chiu9287/Arduino_ROBOT/歷年機器人/2024_2輪驅動(避障、PID)/圖片/框架(反).jpg

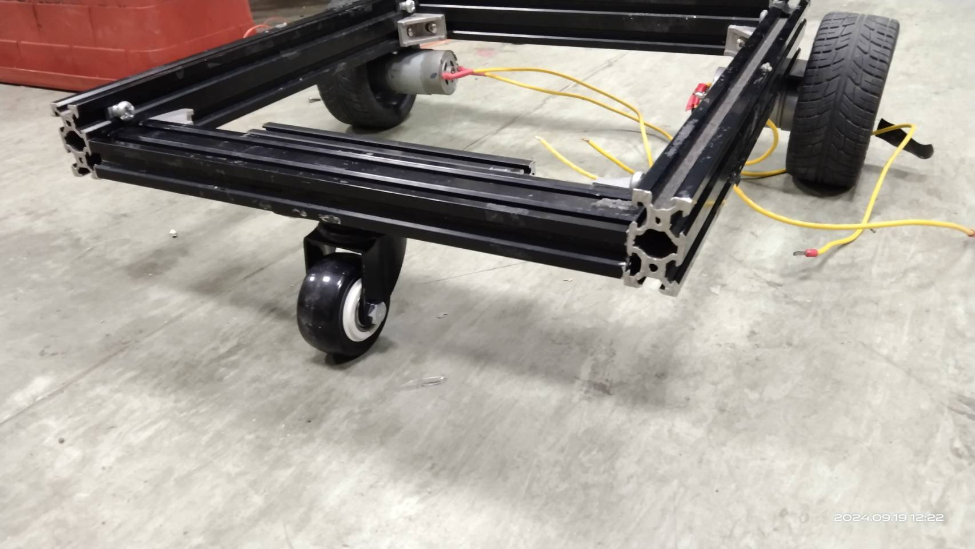
歷年機器人/2024_2輪驅動(避障、PID)/圖片/框架(反).jpg
