chiu9287/Arduino_ROBOT/README.md

# Arduino_ROBOT
黃威仁實驗室_田間機器人

此處存放機器人相關零件資料、製作紀錄以及程式碼，供日後學弟妹製作使用。

## 檔案架構

```
Arduino_ROBOT
├─基本功能
│  ├─程式碼
│  │  └─main
│  └─零件相關資料
│      ├─FSR_402(壓力感測)
│      │  └─程式
│      ├─HX711(電子秤)
│      │  └─程式
│      ├─L298N(燈條控制器)
│      │  └─程式
│      ├─L298N(馬達控制)
│      │  └─程式
│      ├─laser(雷射)
│      │  └─程式
│      ├─LCD_I2C(LCD顯示器)
│      │  └─程式
│      ├─MG_996R(伺服馬達)
│      │  └─程式
│      ├─MPU_6050(陀螺儀)
│      │  └─程式
│      ├─RGB_LED(LED燈泡)
│      │  └─程式
│      ├─SR04(超音波測距)
│      │  └─程式
│      ├─VL35L0X(雷射測距)
│      │  └─程式
│      └─WT61C(陀螺儀)
│          └─程式
└─歷年機器人
    ├─2023_4輪驅動(避障、PID、影像辨識控制)
    │  ├─圖片
    │  ├─影片
    │  └─程式碼
    │      └─main
    ├─2024_2輪驅動(避障、PID)
    │  ├─圖片
    │  ├─影片
    │  └─程式碼
    │      └─main
    ├─2024_木木梟沒有在跟你開玩笑(RGB、雷射、測重、壓力、LCD、陀螺儀)
    │  └─程式碼
    │      ├─Arduino
    │      │  ├─...
    │      └─libraries
    │          ├─...
    ├─2024競賽
    ├─2025_阿不對不隊
    │  ├─室外關
    │  └─程式碼
    │  ├─室內關
    │  └─程式碼
    └─2025競賽

```
