chiu9287/Arduino_ROBOT/歷年機器人/2024競賽/賽道介紹圖.md

## 賽道圖
賽道圖

## 賽道A
賽道A

## 賽道B+C
賽道B

賽道C

## 賽道D
賽道D

## 賽道E
賽道E
