chiu9287/Arduino_ROBOT/歷年機器人/2025競賽/賽道介紹圖.md

# 室外賽道圖
賽道示意圖(室外)

## 賽道A
A

## 賽道B
B

## 賽道C
C

## 賽道D
D

# 室內賽道圖
賽道示意圖1(室內)

賽道示意圖2(室內)
