chiu9287/Arduino_ROBOT/歷年機器人/2024競賽/影片.md

**多組隊伍混剪(嘉義大學生機系)**

``由於影片容量較大，無法放上Github，以下點擊會連結至Youtube``
# 室外賽道(越野)

IMAGE ALT TEXT (https://www.youtube.com/watch?v=qYsMZI6UPVU "Game 1")

# 室內賽道(辨識)

IMAGE ALT TEXT (https://www.youtube.com/watch?v=uqM83qu1ncE "Game 2")
