chiu9287/Arduino_ROBOT/歷年機器人/2023_4輪驅動(避障、PID、影像辨識控制)/影片/影片.md

PID直線校正測試

https://github.com/user-attachments/assets/b91595df-e518-4be8-b00a-a6751a1da1d2

避障+PID測試

https://github.com/user-attachments/assets/b93b3dd5-9b96-4b15-a330-951da203836e

辨識夾取

https://github.com/user-attachments/assets/baa0525e-e5e3-447e-acc7-d46b2e3bca30
