chiu9287/Arduino_ROBOT/歷年機器人/2024_2輪驅動(避障、PID)/影片/2024田間機器人競賽.md

## 賽道圖



## 賽道A



https://github.com/user-attachments/assets/8daa1297-76f1-43bd-bda2-f0ec82608357

## 賽道B+C





https://github.com/user-attachments/assets/874fdefa-7e50-4730-a222-a5a834ed0305

## 賽道D



``很不幸的，我們在這關切換關卡的鍵盤按鈕壞掉了，所以這關跳過，不過基本上就是影片區的U字迴轉左轉版本``

## 賽道E



https://github.com/user-attachments/assets/2829fc0f-21d9-437d-a2fc-296eeccdbac3
