chiu9287/Arduino_ROBOT/歷年機器人/2024_2輪驅動(避障、PID)/影片/影片.md

U字迴轉(行走、避障、校正)

https://github.com/user-attachments/assets/bd972619-98b6-4102-b54e-9a440bea1eb4
