chiu9287/Arduino_ROBOT/基本功能/零件相關資料/FSR_402(壓力感測)/FSR402接線圖.jpg

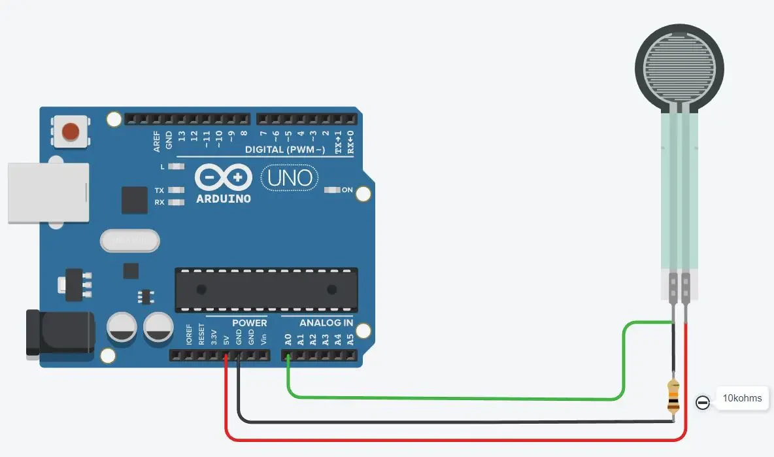
基本功能/零件相關資料/FSR_402(壓力感測)/FSR402接線圖.jpg
