chiu9287/Arduino_ROBOT/基本功能/零件相關資料/HX711(電子秤)/HX711接線圖.png

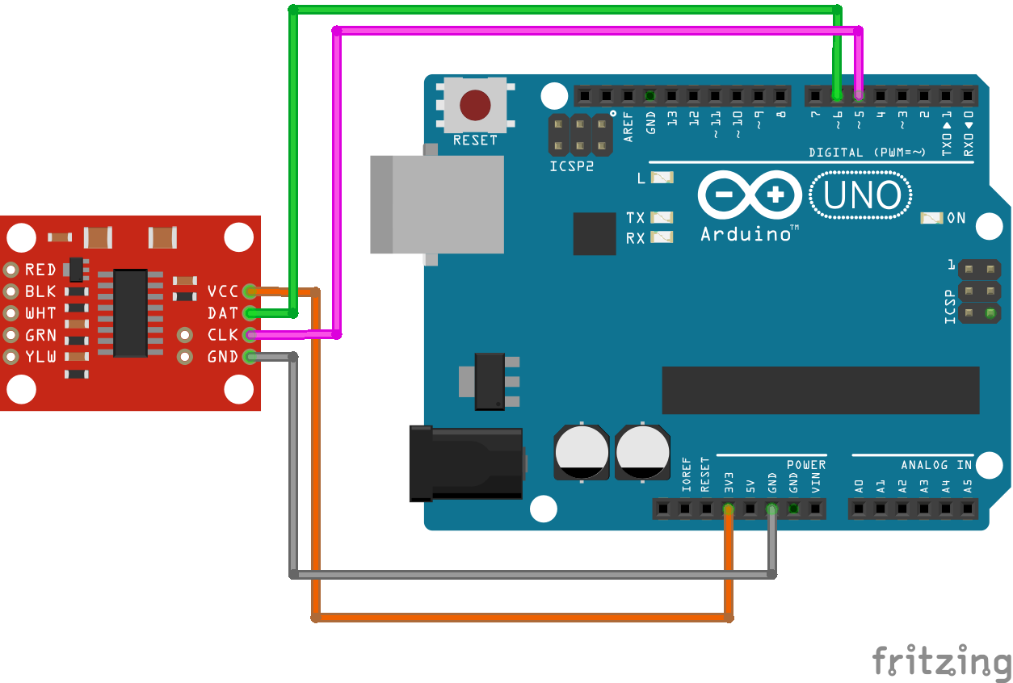
基本功能/零件相關資料/HX711(電子秤)/HX711接線圖.png
