chiu9287/Arduino_ROBOT/基本功能/零件相關資料/L298N(燈條控制器)/L298N燈條接線圖.jpg

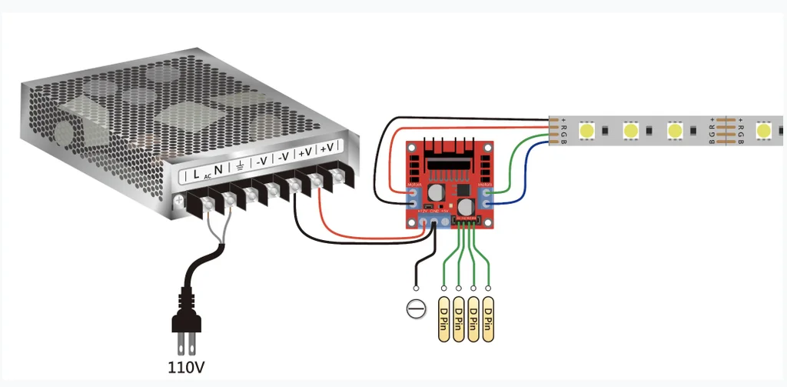
基本功能/零件相關資料/L298N(燈條控制器)/L298N燈條接線圖.jpg
