chiu9287/Arduino_ROBOT/基本功能/零件相關資料/L298N(馬達控制)/L298N孔位圖.png

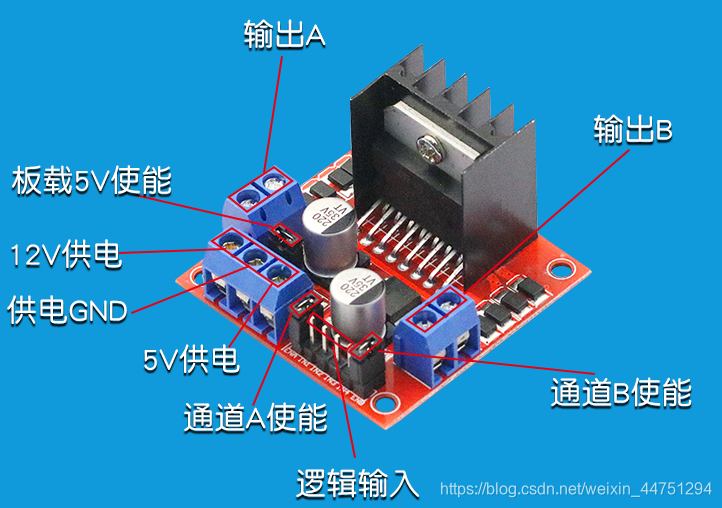
基本功能/零件相關資料/L298N(馬達控制)/L298N孔位圖.png
