chiu9287/Arduino_ROBOT/基本功能/零件相關資料/laser(雷射)/laser接線圖.jpg

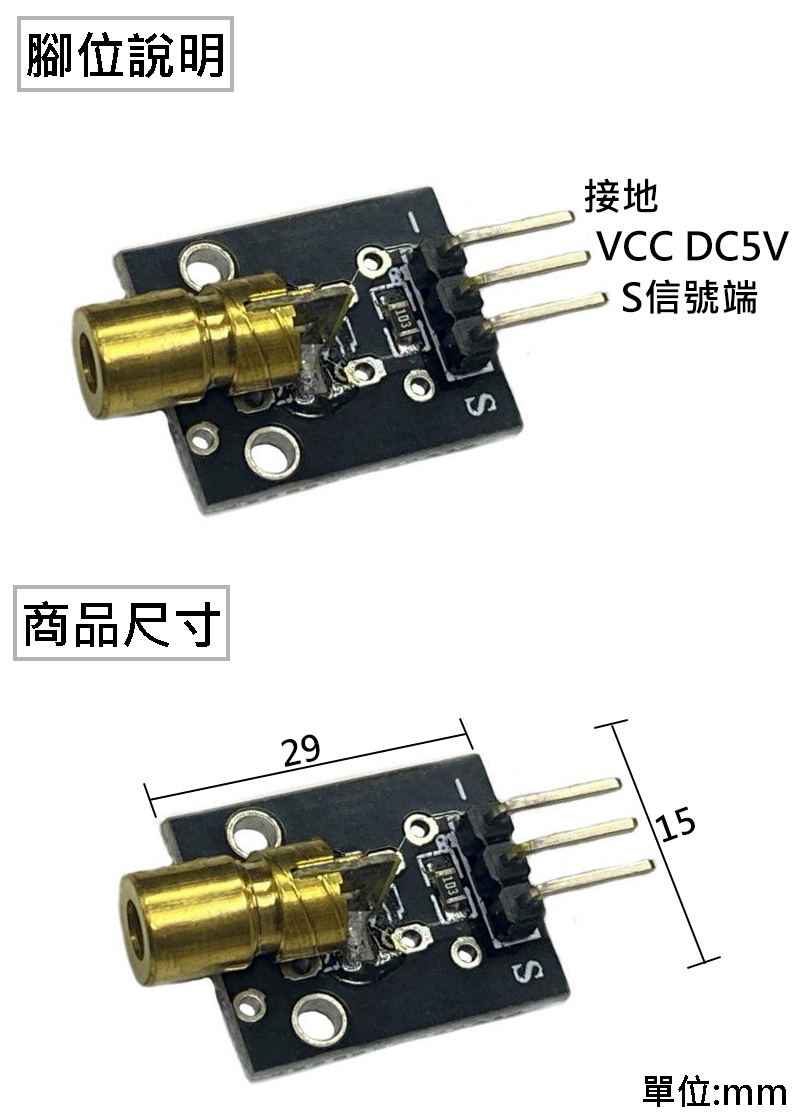
基本功能/零件相關資料/laser(雷射)/laser接線圖.jpg
