chiu9287/Arduino_ROBOT/基本功能/零件相關資料/LCD_I2C(LCD顯示器)/LCD_I2C接線圖.jpg

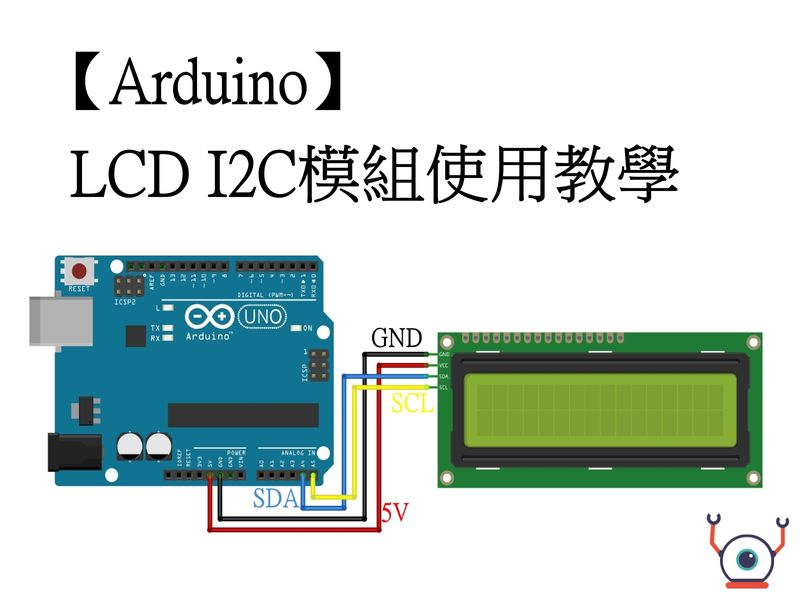
基本功能/零件相關資料/LCD_I2C(LCD顯示器)/LCD_I2C接線圖.jpg
