chiu9287/Arduino_ROBOT/基本功能/零件相關資料/MPU_6050(陀螺儀)/MPU6050接線圖.jpeg

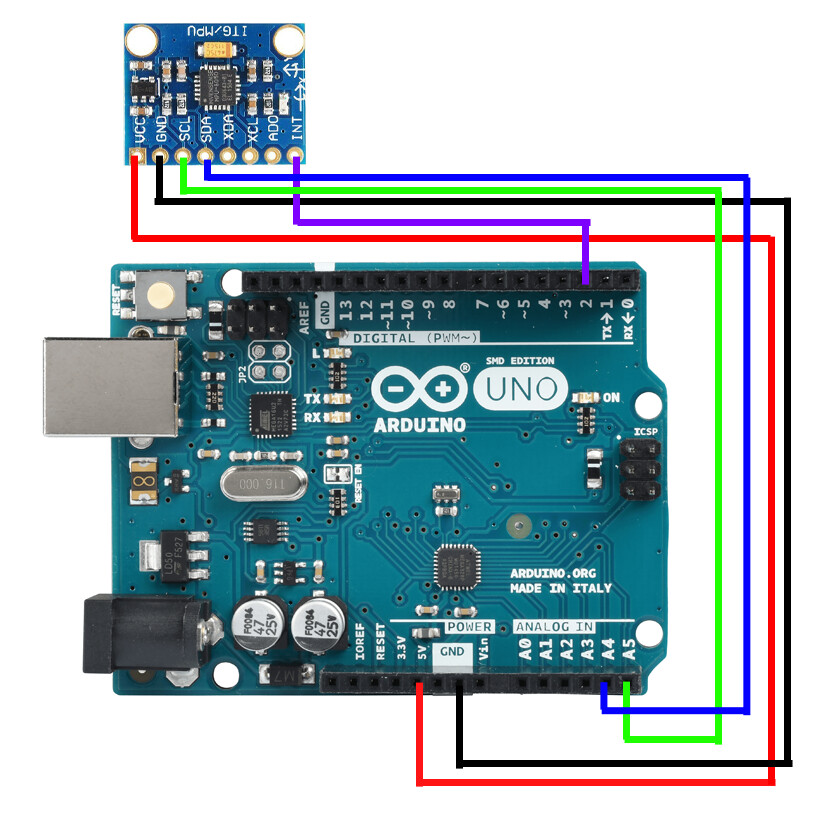
基本功能/零件相關資料/MPU_6050(陀螺儀)/MPU6050接線圖.jpeg
