chiu9287/Arduino_ROBOT/基本功能/零件相關資料/RGB_LED(LED燈泡)/RGB_LED接線圖.png

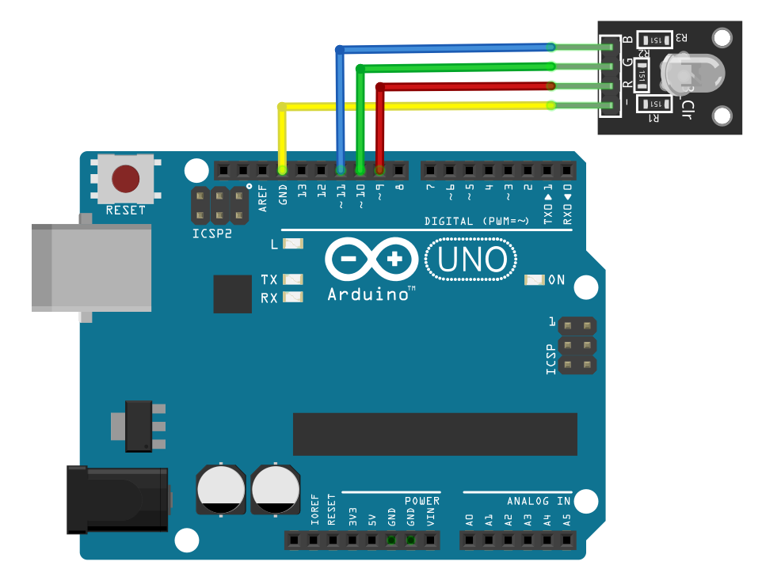
基本功能/零件相關資料/RGB_LED(LED燈泡)/RGB_LED接線圖.png
