chiu9287/Arduino_ROBOT/基本功能/零件相關資料/SR04(超音波測距)/HC-SR04接線圖.png

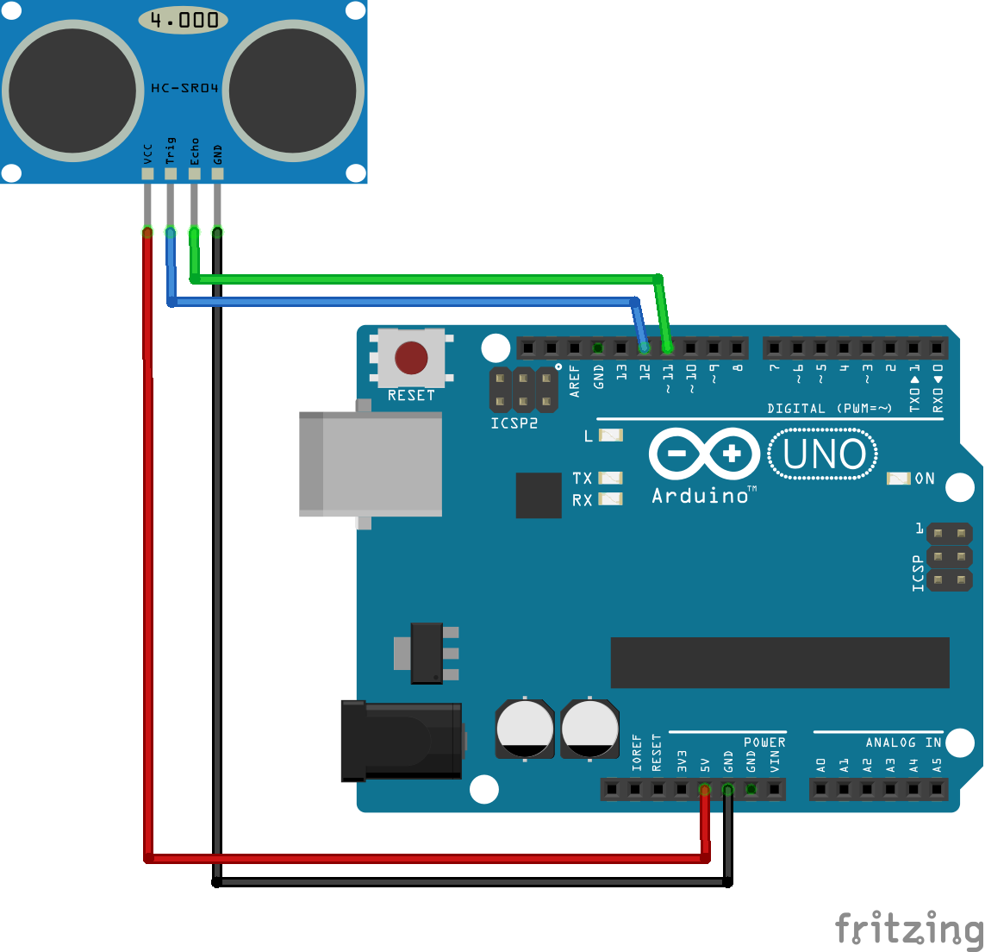
基本功能/零件相關資料/SR04(超音波測距)/HC-SR04接線圖.png
