chiu9287/Arduino_ROBOT/基本功能/零件相關資料/VL35L0X(雷射測距)/VL53L0X接線圖.png

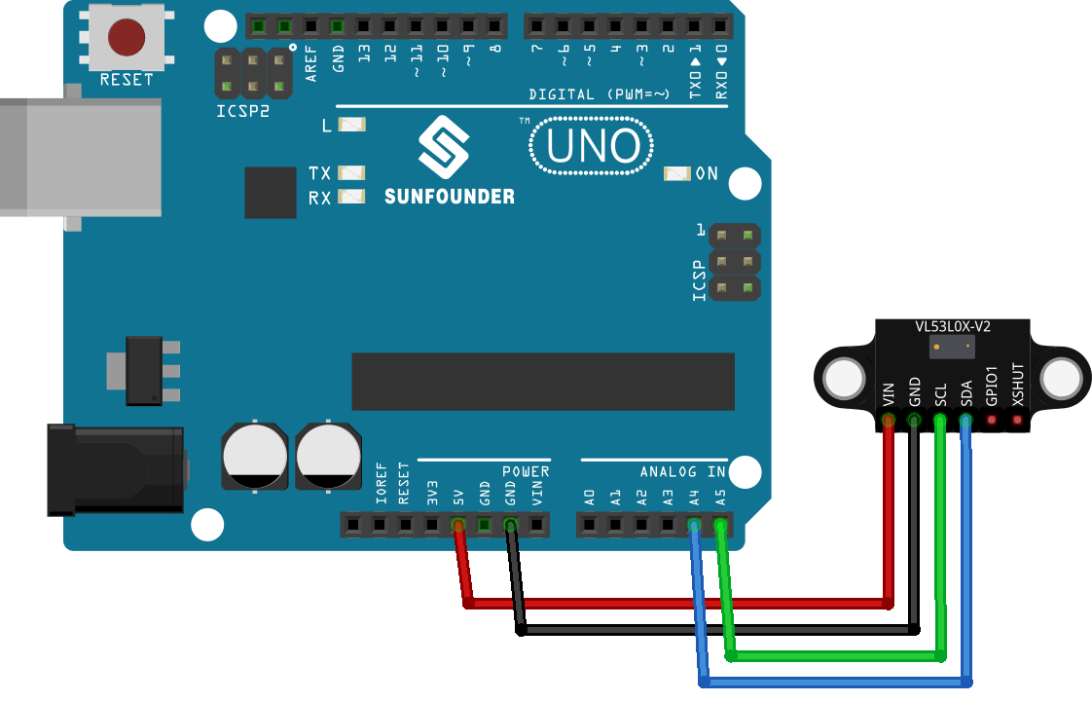
基本功能/零件相關資料/VL35L0X(雷射測距)/VL53L0X接線圖.png
