chiu9287/Arduino_ROBOT/歷年機器人/2023_4輪驅動(避障、PID、影像辨識控制)/圖片/底盤電路圖.jpg

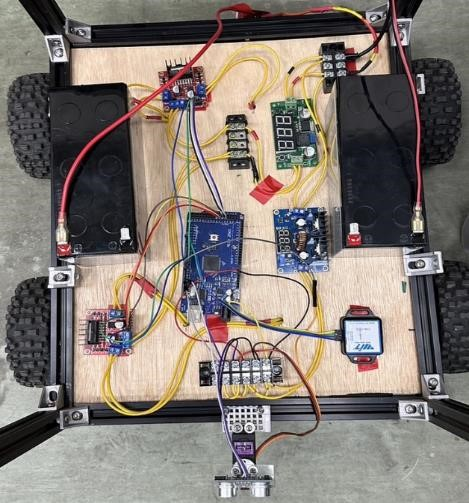
歷年機器人/2023_4輪驅動(避障、PID、影像辨識控制)/圖片/底盤電路圖.jpg
