chiu9287/Arduino_ROBOT/歷年機器人/2024_木木梟沒有在跟你開玩笑(RGB、雷射、測重、壓力、LCD、陀螺儀)/程式碼/Arduino/MG_996R/MG_996R.ino

#include <Servo.h>

// 定義伺服馬達接腳
#define SERVO_PIN 9

// 建立Servo物件
Servo servoMotor;

void setup() {
  // 初始化串口通訊
  Serial.begin(9600);
  
  // 連接伺服馬達到指定的腳位
  servoMotor.attach(SERVO_PIN);
  
  // 伺服馬達歸位
  servoMotor.write(90);
  delay(500); // 等待伺服馬達就位
}

void loop() {
  // 從串口接收指令
  if (Serial.available() > 0) {
    int angle = Serial.parseInt(); // 讀取角度值
    
    // 確保角度在有效範圍內
    if (angle >= 0 && angle <= 180) {
      // 控制伺服馬達轉動到指定角度
      servoMotor.write(angle);
      Serial.print("Moving to angle: ");
      Serial.println(angle);
    } else {
      Serial.println("Invalid angle! Angle should be between 0 and 180 degrees.");
    }
  }
}
