chiu9287/Arduino_ROBOT/歷年機器人/2024_木木梟沒有在跟你開玩笑(RGB、雷射、測重、壓力、LCD、陀螺儀)/程式碼/Arduino/FSR_402/FSR_402.ino

const int sensorPin = A0; 
int sensorValue = 0; 

void setup() {
  Serial.begin(9600);  
  pinMode(sensorPin, INPUT); 
}

void loop() {
  sensorValue = digitalRead(sensorPin);  
  if(sensorValue != 0){
    Serial.println("TOUCH");          
  }else{
    Serial.println("NO SIGNAL");     
  }
    delay(500);
}
