chiu9287/Arduino_ROBOT/歷年機器人/2024_木木梟沒有在跟你開玩笑(RGB、雷射、測重、壓力、LCD、陀螺儀)/程式碼/Arduino/HX711/HX711.ino

/*
  本範例為HX711的校正程式
  
  需先安裝Bogdan Necula的HX711函式庫
  https://github.com/bogde/HX711
  
  傑森創工製作
  
  粉絲團：
  https://www.facebook.com/jasonshow
  
  傑森創工部落格：
  https://blog.jmaker.com.tw/

  傑森創工賣場：https://goo.gl/EWoPQ4

 */
#include "HX711.h"

// HX711 接線設定
const int DT_PIN = 13;
const int SCK_PIN = 12;
const int sample_weight = 100;  //基準物品的真實重量(公克)

HX711 scale;

void setup() {
  Serial.begin(9600);
  scale.begin(DT_PIN, SCK_PIN);
  scale.set_scale();  // 開始取得比例參數
  scale.tare();
  Serial.println("Nothing on it.");
  Serial.println(scale.get_units(10));
  Serial.println("Please put sapmple object on it..."); //提示放上基準物品
  
}

void loop() {
  float current_weight=scale.get_units(10);  // 取得10次數值的平均
  float scale_factor=(current_weight/sample_weight);
  Serial.print("Scale number:  ");
  Serial.println(scale_factor,0);  // 顯示比例參數，記起來，以便用在正式的程式中
  
}
