chiu9287/Arduino_ROBOT/歷年機器人/2024_木木梟沒有在跟你開玩笑(RGB、雷射、測重、壓力、LCD、陀螺儀)/程式碼/Arduino/LED_lightStrip(L298N)/LED_lightStrip(L298N).ino

const int IN1 = A12;  // 共陽
const int G = A13;
const int R = A14;
const int B = A15;


void setup() {
  pinMode(IN1, OUTPUT);
  pinMode(R, OUTPUT);
  pinMode(G, OUTPUT);
  pinMode(B, OUTPUT);

  digitalWrite(IN1, HIGH);

}
void loop() {
  analogWrite(R, 0);     // 紅色通道 (共陽極)
  analogWrite(G, 255); // 綠色通道 (共陽極)
  analogWrite(B, 255);
  delay(500);
  analogWrite(R, 255);     // 紅色通道 (共陽極)
  analogWrite(G, 0); // 綠色通道 (共陽極)
  analogWrite(B, 255);
  delay(500);
  analogWrite(R, 255);     // 紅色通道 (共陽極)
  analogWrite(G, 255); // 綠色通道 (共陽極)
  analogWrite(B, 0);
  delay(500);
}
