chiu9287/Arduino_ROBOT/歷年機器人/2023_4輪驅動(避障、PID、影像辨識控制)/程式碼/main/SR04.ino

float ping_d() { /*探測距離*/
  digitalWrite(F_Trig, HIGH);
  delayMicroseconds(2);
  digitalWrite(F_Trig, LOW);
  float distance = pulseIn(F_Echo, HIGH, 6000);
  distance = (distance / 2) * 0.0347;
  return distance;
}
