chiu9287/Arduino_ROBOT/歷年機器人/2023_4輪驅動(避障、PID、影像辨識控制)/程式碼/main/WT61C.ino

void Event() {
  while (Serial2.available()) {
    Re_buf[counter] = (unsigned char)Serial2.read();
    if (counter == 0 && Re_buf[0] != 0x55) return;  //第0号数据不是帧头
    counter++;
    if (counter == 11)  //接收到11个数据
    {
      counter = 0;  //重新赋值，准备下一帧数据的接收
      sign = 1;
      if (Re_buf[0] != 0x55 || Re_buf[1] != 0x53) sign = 0;  //第0号数据不是帧头
    }
  }
}
void REset() {
  Serial.println("RESET");
  Serial2.write(0xFF);
  Serial2.write(0xAA);
  Serial2.write(0x52);
}
void checkMPU() {
  Event();
  if (sign) {
    sign = 0;
    if (Re_buf[0] == 0x55 && Re_buf[1] == 0x53)  //检查帧头
    {
      ANG = (short(Re_buf[7] << 8 | Re_buf[6])) / 32768.0 * 180;
      pitch = (short(Re_buf[3] << 8 | Re_buf[2])) / 32768.0 * 180;
      roll = (short(Re_buf[5] << 8 | Re_buf[4])) / 32768.0 * 180;
    }
  }
}
